sbhackerspace/max-button/2018-12-16T000404.xlsx

Index | Quantity | Part Number | Manufacturer Part Number | Description | Customer Reference | Available | Backorder | Unit Price | Extended Price USD
1 | 6 | ATSAMD21G18A-MUTCT-ND | ATSAMD21G18A-MUT | IC MCU 32BIT 256KB FLASH 48QFN |  | 6 | 0 | 3.15 | 18.90
2 | 100 | RR05P10.0KDCT-ND | RR0510P-103-D | RES SMD 10K OHM 0.5% 1/16W 0402 |  | 100 | 0 | 0.0299 | 2.99
3 | 100 | 1276-1004-1-ND | CL05F104ZO5NNNC | CAP CER 0.1UF 16V Y5V 0402 |  | 100 | 0 | 0.0106 | 1.06
4 | 10 | DS2413P+-ND | DS2413P+ | IC ADDRESSABLE SWITCH 6TSOC |  | 10 | 0 | 2.318 | 23.18
5 | 10 | F2112CT-ND | 1206L050YR | PTC RESET FUSE 6V 500MA 1206 |  | 10 | 0 | 0.505 | 5.05
6 | 100 | 445-172886-1-ND | MPZ1608D300BTD25 | FERRITE BEAD 30 OHM 0603 1LN |  | 100 | 0 | 0.047 | 4.70
7 | 10 | 609-4613-1-ND | 10118192-0001LF | CONN RCPT USB2.0 MICRO B SMD R/A |  | 10 | 0 | 0.419 | 4.19
8 | 10 | 401-1429-1-ND | KMR231GLFS | SWITCH TACTILE SPST-NO 0.05A 32V |  | 10 | 0 | 0.553 | 5.53
9 | 100 | 576-4905-1-ND | MIC5501-3.0YM5-TR | IC REG LINEAR 3V 300MA SOT23-5 |  | 100 | 0 | 0.0824 | 8.24
10 | 10 | SAM8909-ND | FTSH-105-01-F-D-K | CONN HEADER 10POS DUAL VERT |  | 10 | 0 | 2.78 | 27.80
11 | 100 | 311-4.7KJRCT-ND | RC0402JR-074K7L | RES SMD 4.7K OHM 5% 1/16W 0402 |  | 100 | 0 | 0.0057 | 0.57
12 | 20 | 609-6302-1-ND | 10147606-00004LF | MINITEK 1.0MM R/A SMT HEADER |  | 20 | 0 | 0.564 | 11.28
13 | 10 | 296-25216-1-ND | TPD2S017DBVR | IC ESD SOLUTION 2CH SOT23-6 |  | 10 | 0 | 0.568 | 5.68
