sbhackerspace/max-button/devils-rectangle.pdf

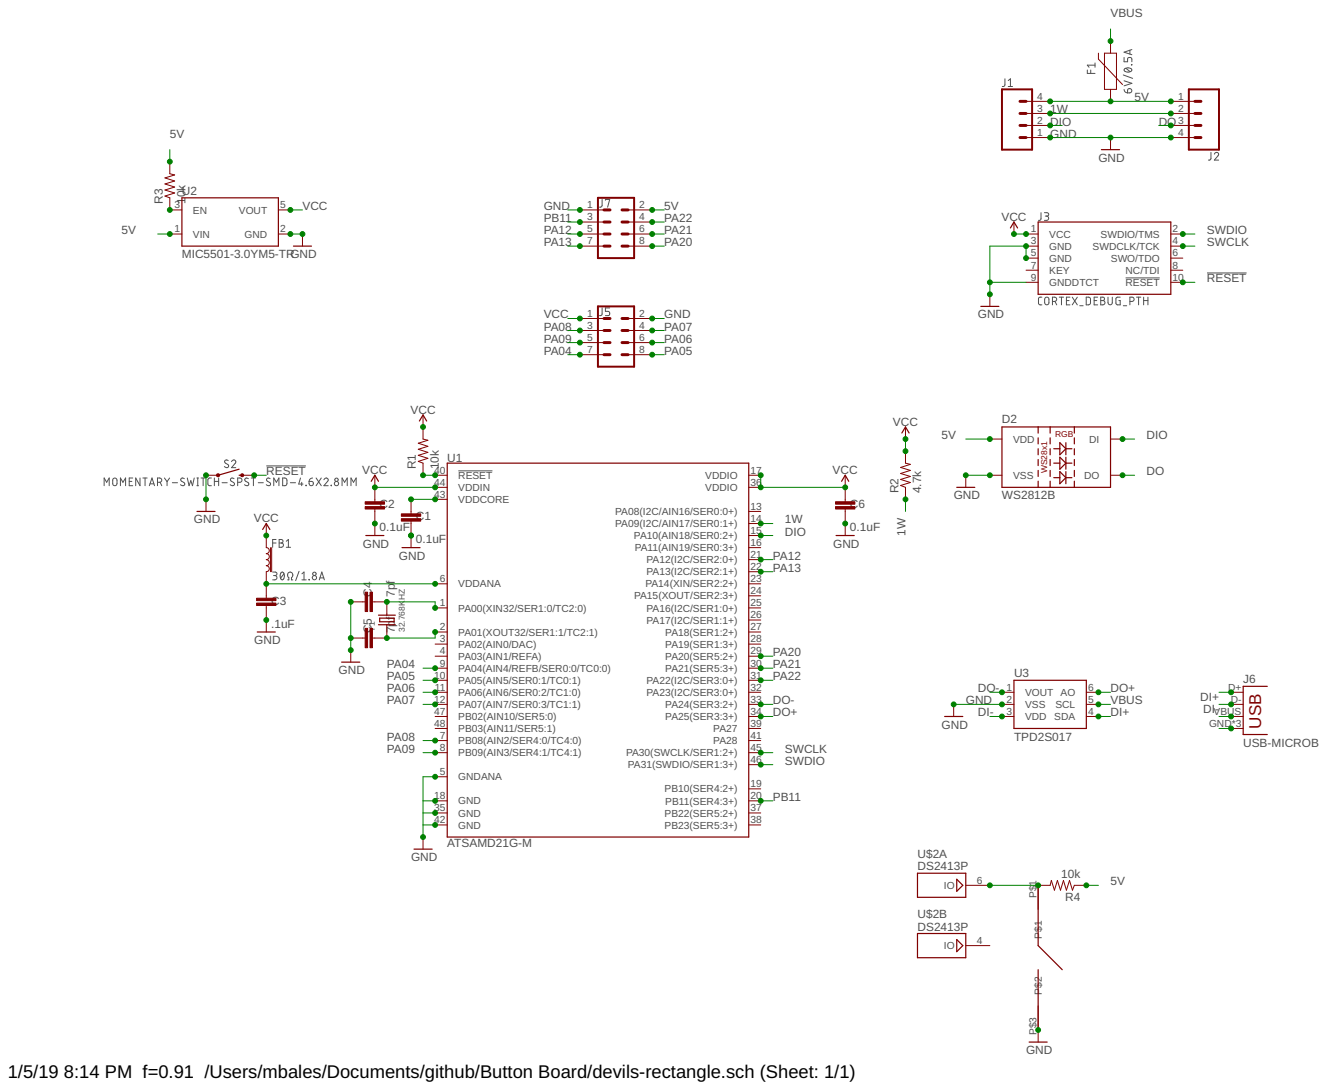
[picture p1: page 1]

1/5/19 8:14 PM f=0.91 /Users/mbales/Documents/github/Button Board/devils-rectangle.sch (Sheet: 1/1)
