sbhackerspace/max-button/devils-rectangle.brd

## EAGLE design devils-rectangle.brd (2020-01-18)

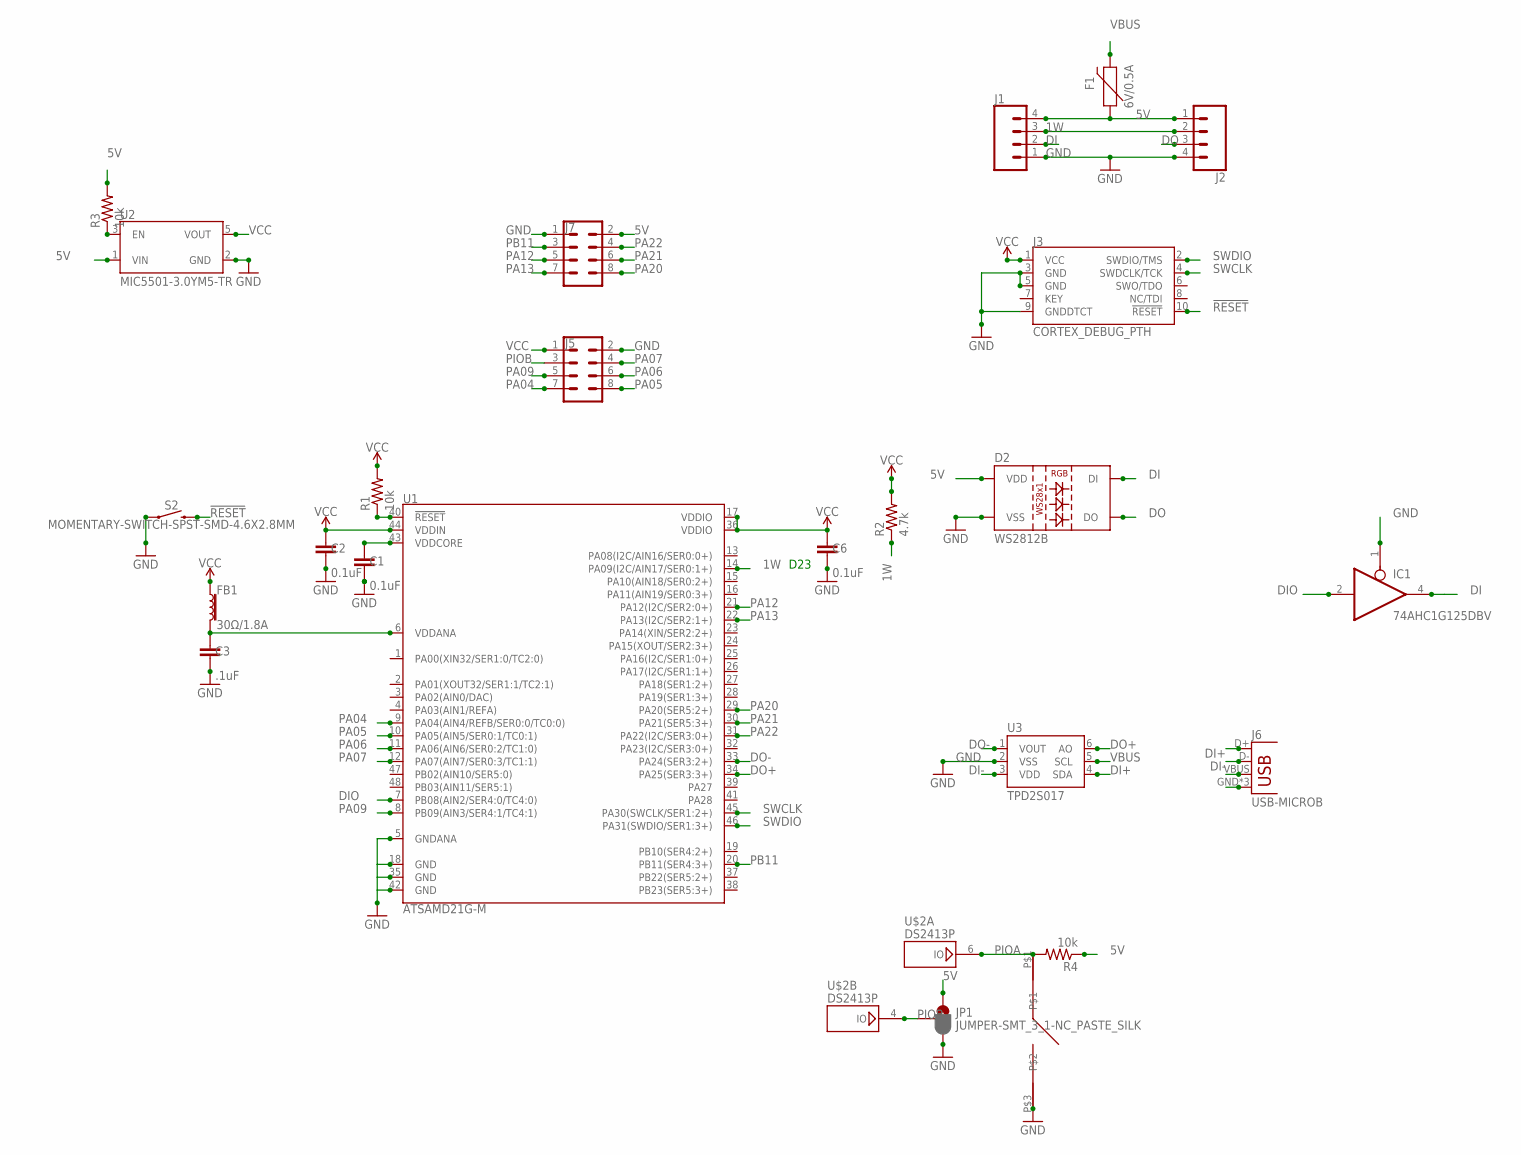
[picture p2: schematic devils-rectangle.sch]

Parts:
C1, C2, C6: 0.1uF; 0402
C3: .1uF; 0402
D2: WS2812B
F1: 6V/0.5A; 1206
FB1: 30Ω/1.8A; 0603
IC1: 74AHC1G125DBV; SOT23-5
J1, J2: CONN_04SMD2; 1X04_1MM_RA
J3: CORTEX_DEBUG_PTH; 2X5-PTH-1.27MM
J5, J7: CONN_04X2; 2X4
J6: USB-MICROB
JP1: JUMPER-SMT_3_1-NC_PASTE_SILK; SMT-JUMPER_3_1-NC_PASTE_SILK
R1, R3, R4: 10k; R0402
R2: 4.7k; R0402
S2: MOMENTARY-SWITCH-SPST-SMD-4.6X2.8MM; TACTILE_SWITCH_SMD_4.6X2.8MM
U1: ATSAMD21G-M; QFN-48
U2: MIC5501-3.0YM5-TR; SOT95P280X145-5N
U3: TPD2S017; SOT23-6
U$1: NOVELKEY
U$2: DS2413P; TSOC6

Connections:
1W: J1.3, J2.2, R2.1, U1.14 (PA09(I2C/AIN17/SER0:1+)), U$2.2 (1W)
5V: D2.1 (VDD), F1.1, IC1.5 (5V), J1.4, J2.1, J7.2, JP1.1, R3.2, R4.1, U2.1 (VIN)
!RESET: J3.10 (!RESET), R1.1, S2.3 (2), S2.4 (2), U1.40 (!RESET!)
DI: D2.4 (DI), IC1.4 (O), J1.2
DI+: J6.D+, U3.4 (SDA)
DI-: J6.D-, U3.3 (VDD)
DIO: IC1.2 (I), U1.7 (PB08(AIN2/SER4:0/TC4:0))
DO: D2.2 (DO), J2.3
DO+: U1.34 (PA25(SER3:3+)), U3.6 (AO)
DO-: U1.33 (PA24(SER3:2+)), U3.1 (VOUT)
GND: C1.2, C2.2, C3.2, C6.2, D2.3 (VSS), IC1.1 (OE), IC1.3 (GND), J1.1, J2.4, J3.3 (GND), J3.5 (GND), J3.9 (GNDDTCT), J5.2, J6.GND, J6.MT1 (GND), J6.MT2 (GND), J7.1, JP1.3, S2.1, S2.2 (1), U1.5 (GNDANA), U1.18 (GND), U1.35 (GND), U1.42 (GND), U2.2 (GND), U3.2 (VSS), U$1.P$3, U$2.1 (GND), U$2.5 (GND)
unnamed: R3.1, U2.3 (EN)
unnamed: C3.1, FB1.2, U1.6 (VDDANA)
unnamed: C1.1, U1.43 (VDDCORE)
PA04: J5.7, U1.9 (PA04(AIN4/REFB/SER0:0/TC0:0))
PA05: J5.8, U1.10 (PA05(AIN5/SER0:1/TC0:1))
PA06: J5.6, U1.11 (PA06(AIN6/SER0:2/TC1:0))
PA07: J5.4, U1.12 (PA07(AIN7/SER0:3/TC1:1))
PA09: J5.5, U1.8 (PB09(AIN3/SER4:1/TC4:1))
PA12: J7.5, U1.21 (PA12(I2C/SER2:0+))
PA13: J7.7, U1.22 (PA13(I2C/SER2:1+))
PA20: J7.8, U1.29 (PA20(SER5:2+))
PA21: J7.6, U1.30 (PA21(SER5:3+))
PA22: J7.4, U1.31 (PA22(I2C/SER3:0+))
PB11: J7.3, U1.20 (PB11(SER4:3+))
PIOA: R4.2, U$1.P$1, U$2.6 (IO)
PIOB: J5.3, JP1.2, U$2.4 (IO)
SWCLK: J3.4 (SWDCLK/TCK), U1.45 (PA30(SWCLK/SER1:2+))
SWDIO: J3.2 (SWDIO/TMS), U1.46 (PA31(SWDIO/SER1:3+))
VBUS: F1.2, J6.VBUS, U3.5 (SCL)
VCC: C2.1, C6.1, FB1.1, J3.1 (VCC), J5.1, R1.2, R2.2, U1.17 (VDDIO), U1.36 (VDDIO), U1.44 (VDDIN), U2.5 (VOUT)

Notes on the sheet:
D23

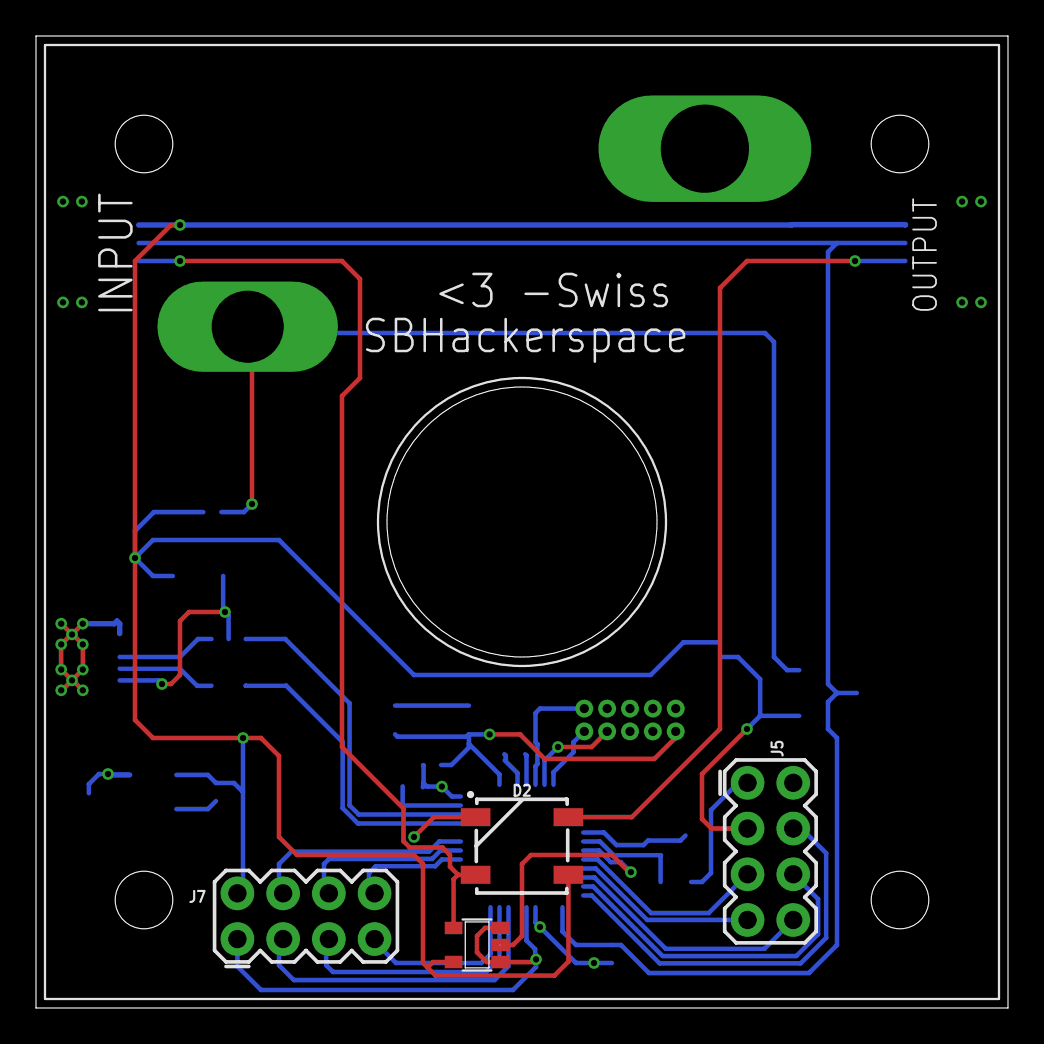
[picture p3: board devils-rectangle.brd from above]

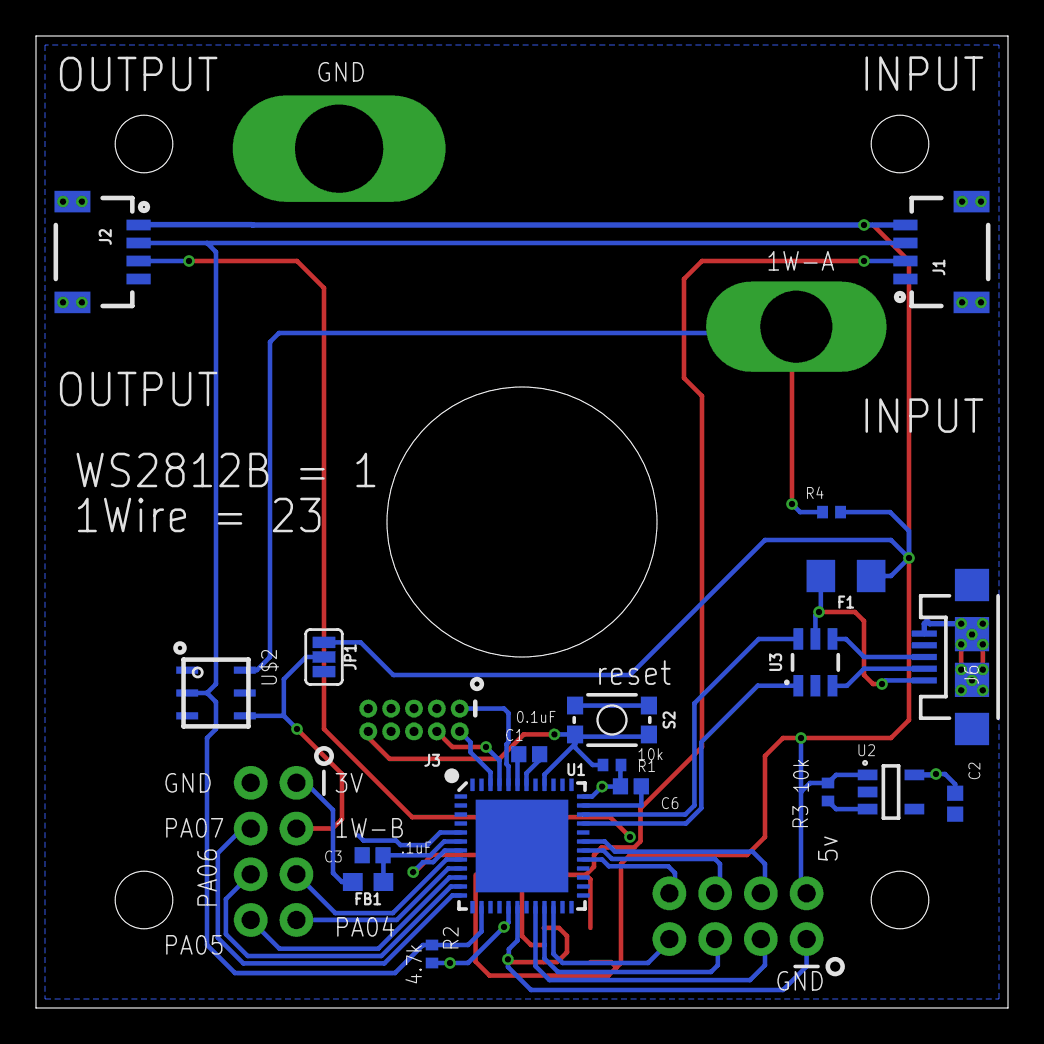
[picture p4: board devils-rectangle.brd from below]

Board: 2 copper layers, 54.0 x 54.0 mm, 25 parts (20 on the bottom side), 31 nets.
