sbhackerspace/max-button/(threads)

Thread 1 (2019-01-06):

rev2 board issues

slapplebags, 2019-01-06:
3v is not enough to drive the ws2812b leds, need a level shifter to shift to 5v
ds2413 example sketch does not compile on current bootloader
