sbhackerspace/max-button/(commit log)

2018-12-02 initial commit
    first revision of a breakout for the novelkey giant mx switches. The goal i sto create an inexpensive open source bussable breakout and controller board.
    [untitled.brd, untitled.sch]
2018-12-04 corrected button orientation
    placed novelkey on the correct side. reduced gpio by 2 pins to allow for tolerances. added mounting hole. updated routing.
    [untitled.brd, untitled.sch]
2018-12-04 updated silkscreen
    updated silkscreen
    [untitled.brd, untitled.sch]
2018-12-04 jplc gerbers
    generated a set of gerbers for JPLC PCBs
    [copper_bottom.gbr, copper_top.gbr, drills.xln, gerber_job.gbrjob, profile.gbr, silkscreen_bottom.gbr, silkscreen_top.gbr, soldermask_bottom.gbr]
2018-12-06 added esp version and removed led
    added an esp8266 version of the board. Removed an LED from the samd21g version to move the LED to the empty space on the bottom of the novelkey.
    [novelkey esp.brd, novelkey esp.sch, untitled.brd, untitled.sch]
2018-12-06 added vias below usb
    added gnd vias below the USB connector to improve mechanical stability.
    [untitled.brd]
2018-12-06 removed air wire
    removed air wire error on U$2
    [untitled.brd]
2018-12-06 added vias below bus connectors
    added vias below bus connectors to improve mechanical stability. Added ground symbol on bus connection net.
    [untitled.brd, untitled.sch]
2018-12-06 fixed wire stub drc error
    removed wire stub on the USB connection vias.
    [untitled.brd]
2018-12-06 changed button from 3v to 5v
    moved button from 3v to 5v as the ds2413 is 5v tolerant and 5v is passed via the bus connector while 3v is not. Also negates the need for a vreg on each board.
    [untitled.brd, untitled.sch]
2018-12-16 Rev 1 error fixes
    Updated ldo pull up resistor to Vin. Moved part values to layer that will show up in silkscreen. Updated capacitor footprint to match proper 0402 sizing. Replaced usb tvs/res IC. increased pullback.
    [untitled.brd, untitled.sch]
2018-12-16 added BOM
    digikey cart bom
    [2018-12-16T000404.xlsx]
2018-12-16 rev 2 fab
    rev 2 sent to fab
    [copper_bottom.gbr, copper_top.gbr, drills.xln, gerber_job.gbrjob, profile.gbr, silkscreen_bottom.gbr, silkscreen_top.gbr, soldermask_bottom.gbr]
2018-12-17 Updated Routing
    Updated routing to remove vias. Changed switch wiring to reflect ds2413 example circuit.
    [untitled.brd, untitled.sch]
2018-12-17 added crystal
    added a 32khz crystal per the arduino zero spec. updated routing to fit the crystal and caps.
    [untitled.brd, untitled.sch]
2018-12-17 moved digital traces
    moved digital IO traces to allow more space in between.
    [untitled.brd]
2018-12-17 updated ldo silkscreen
    updated silkscreen on the ldo to prevent overlaps
    [untitled.brd]
2018-12-17 added via to button pullup
    added a via to the button pullup to shorten distance to ground.
    [untitled.brd, untitled.sch]
2018-12-17 minor cleanup
    minor cleanup
    [untitled.brd]
2018-12-17 schematic cleanup
    cleaned up schematic organization
    [untitled.brd, untitled.sch]
2018-12-23 Reselved VDDCORE error - rev 3
    removed connection from vddcore to vcc that was causing a short burning out the internal arm regulator.
    [untitled.brd, untitled.sch]
2019-01-06 backing up changes
    backing up changes
    [untitled.brd, untitled.sch]
2019-01-06 updated gitignore and renamed project `
    [devils-rectangle.brd, devils-rectangle.sch, novelkey esp.brd, novelkey esp.sch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]
2019-01-06 updated naming
    [untitled.brd, untitled.sch]
2019-08-24 updated bus switch
    updated bus switch to i2c to resolve arduino zero issue with onewire
    [devils-rectangle.brd, devils-rectangle.sch]
2019-08-25 replaced i2c port expander
    replaced i2c port expander with an attiny85. added 3v pin to daughter board header.
    [devils-rectangle.brd, devils-rectangle.sch]
2019-12-30 resolved routing errors
    resolved routing errors, added crystal, and tested. submitted to oshpark.
    [devils-rectangle.brd, devils-rectangle.sch]
2020-01-17 Revert "sent to fab"
    This reverts commit 4395226a2b02ff09c6c76ca9ff8e8c36c153bf92, reversing
    changes made to 6eea5bdc47f5d2efe417c0b61bc92f1f556a86fc.
    [devils-rectangle.brd, devils-rectangle.sch]
2020-01-17 sent to fab
    sent to fab, errors on board
    [devils-rectangle.brd, devils-rectangle.sch]
2020-01-17 rev 3
    fixed errors, sent to fab.
    [devils-rectangle.brd, devils-rectangle.sch]
2020-01-17 silkscreen update
    scilkscreen now has I/O definitions
    [devils-rectangle.brd]
2020-01-18 fixed errors
    fixed errors, added breakout for PIOB on DS2413, updated silk screen
    [devils-rectangle.brd, devils-rectangle.sch]
